freetronics/BARO/Baro.brd

## EAGLE design Baro.brd (2014-06-20)

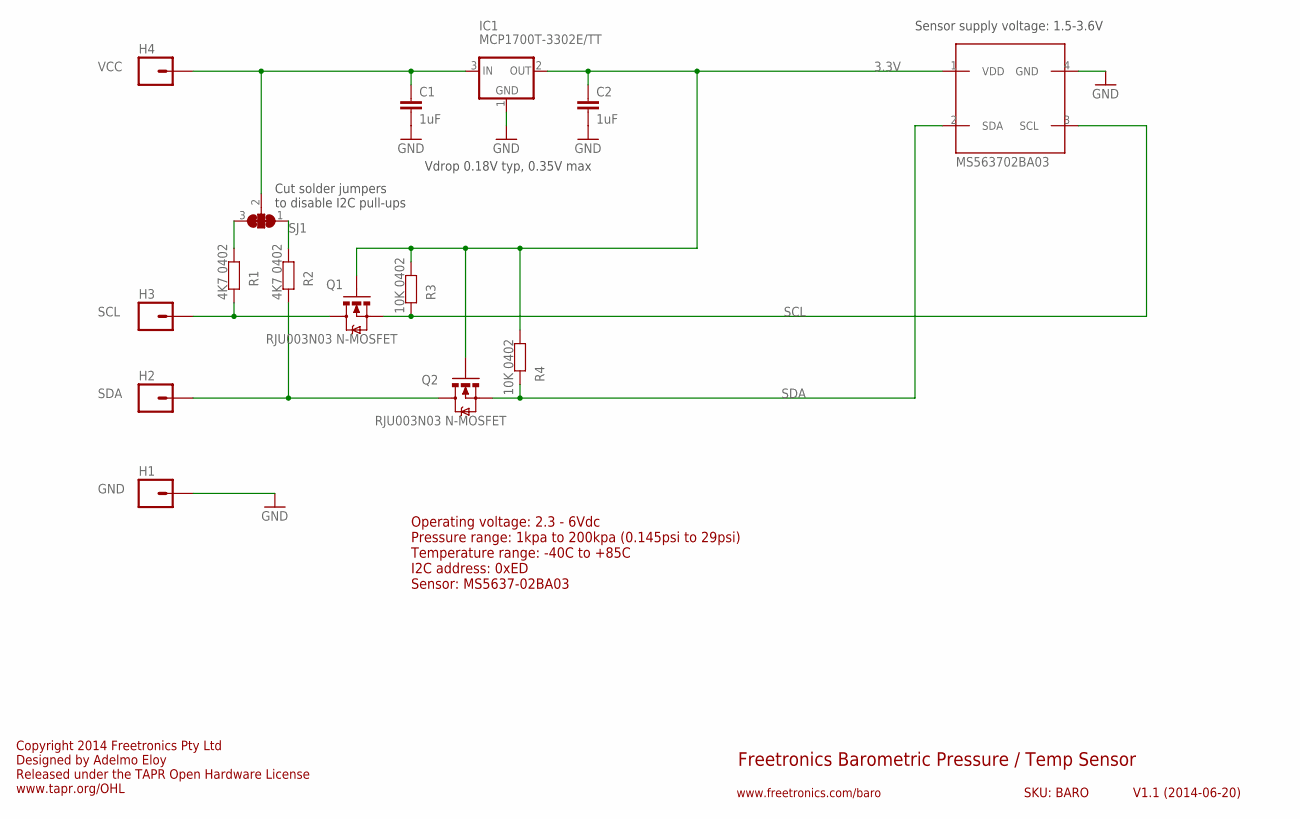
[picture p1: schematic Baro.sch]

Parts:
C1, C2: 1uF; 0603
H1: GND; 1X01
H2: SDA; 1X01
H3: SCL; 1X01
H4: VCC; 1X01
IC1: MCP1700T-3302E/TT; SOT23-3
IC2: MS563702BA03; MS5637
Q1, Q2: RJU003N03 N-MOSFET; SOT32-3
R1, R2: 4K7 0402; 0402
R3, R4: 10K 0402; 0402
SJ1: SJ2W; SJ_2

Connections:
3.3V: C2.1, IC1.2 (OUT), IC2.1 (VDD), Q1.1 (G), Q2.1 (G), R3.2, R4.2
GND: C1.2, C2.2, H1.1, IC1.1 (GND), IC2.4 (GND)
unnamed: IC2.3 (SCL), Q1.2 (S), R3.1
unnamed: C1.1, H4.1, IC1.3 (IN), SJ1.2
unnamed: IC2.2 (SDA), Q2.2 (S), R4.1
unnamed: R1.2, SJ1.3
unnamed: R2.2, SJ1.1
SCL: H3.1, Q1.3 (D), R1.1
SDA: H2.1, Q2.3 (D), R2.1

Notes on the sheet:
Freetronics Barometric Pressure / Temp Sensor
V1.1 (2014-06-20)
www.freetronics.com/baro
SKU: BARO
Sensor supply voltage: 1.5-3.6V
Cut solder jumpers to disable I2C pull-ups
Vdrop 0.18V typ, 0.35V max
Copyright 2014 Freetronics Pty Ltd Designed by Adelmo Eloy Released under the TAPR Open Hardware License www.tapr.org/OHL
Operating voltage: 2.3 - 6Vdc Pressure range: 1kpa to 200kpa (0.145psi to 29psi) Temperature range: -40C to +85C I2C address: 0xED Sensor: MS5637-02BA03

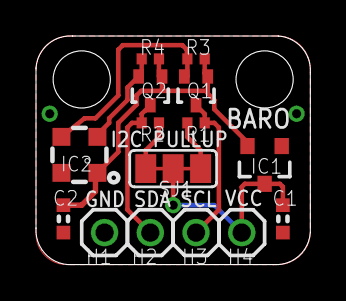
[picture p2: board Baro.brd from above]

Board: 2 copper layers, 15.2 x 12.7 mm, 15 parts (0 on the bottom side), 9 nets.
