freetronics/BARO/(commit log)

2013-12-17 Initial project.
    [Baro.brd, Baro.sch]
2013-12-18 Volt. regulator and FETs added.
    [Baro.brd, Baro.sch]
2014-01-21 Noted Adelmo Eloy as the designer Added license info to schematic Relocated decoupling cap to near sensor Improved ground connection to regulator Added notes to schematic about operating ranges Chang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
    [Baro.brd, Baro.sch]
2014-01-21 Fixed revision date
    [Baro.sch]
2014-01-21 Approved ERC errors
    [Baro.sch]
2014-06-20 Bridged I2C pullup jumpers Shortened URL
    [Baro.brd, Baro.sch]
