freetronics/BARO/(notices)

Notices in the files:
Baro.brd:
(c) 2014 Freetronics
parts and their libraries:
freetronics-original: Licensing: CC v3.0 Share-Alike You are welcome to use this library for commercial purposes.
